frandorturtles/flora/portfolio/FLORA_Smart_Plant_Companion.html

# Flora

frandorturtles

frandorturtles

SHT40

TSL25911

5 V

frandorturtles

frandorturtles

2

ESP32-C3

USB-C, 5 V

KiCad 7

Flora
FRANDORTURTLES
