frandorturtles/flora/portfolio/assets/bottom_view.png

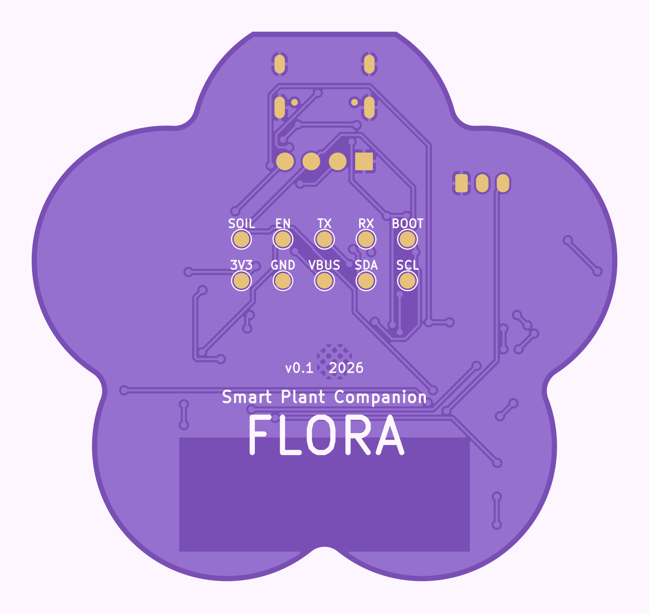
portfolio/assets/bottom_view.png
