frandorturtles/flora/renders/FLORA_board.step

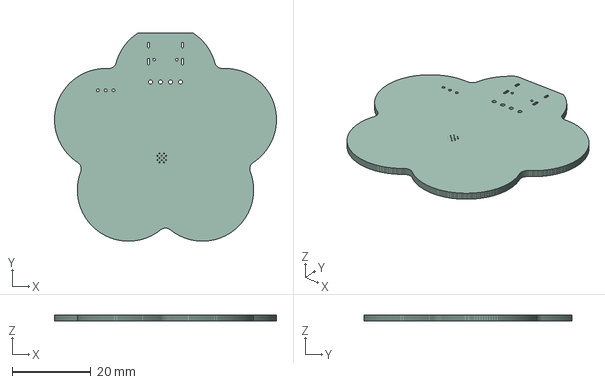
[picture p3: CAD file, 2026-10-29]
renders/FLORA_board.step
56.4 x 52.9 x 1.60 mm
