frandorturtles/flora/renders/assembly_top_fab.png

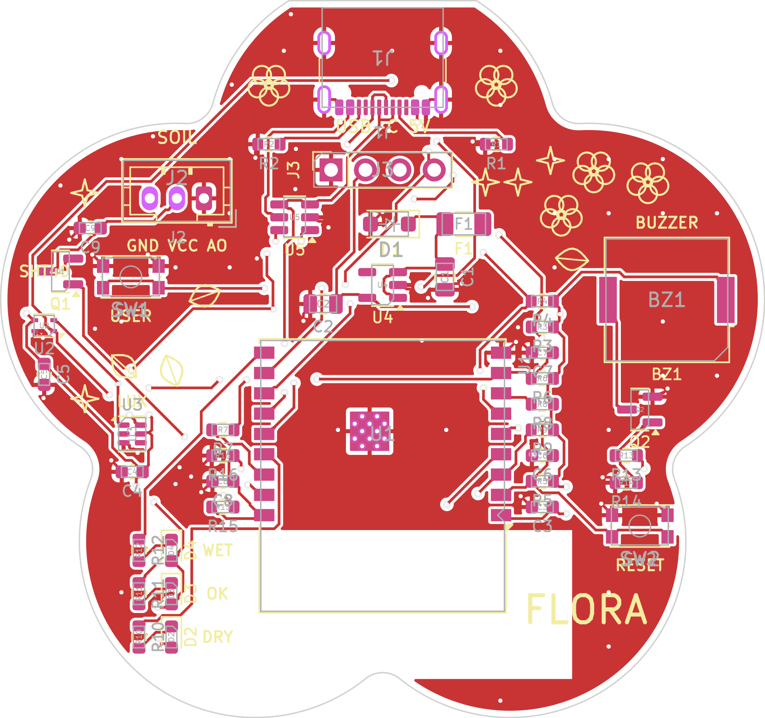
renders/assembly_top_fab.png
