frandorturtles/flora/CHANGELOG.md

# Changelog

## v0.1 — 2026-10-26
- Primer diseño completo: esquemático, PCB en forma de flor, firmware, Gerbers, documentación.
- Sin fabricar ni probar. Ver `documentation/design_review.md` para pendientes.
