frandorturtles/flora/hardware/FLORA.kicad_pcb

## KiCad design hardware/FLORA.kicad_pcb (2026-10-29)

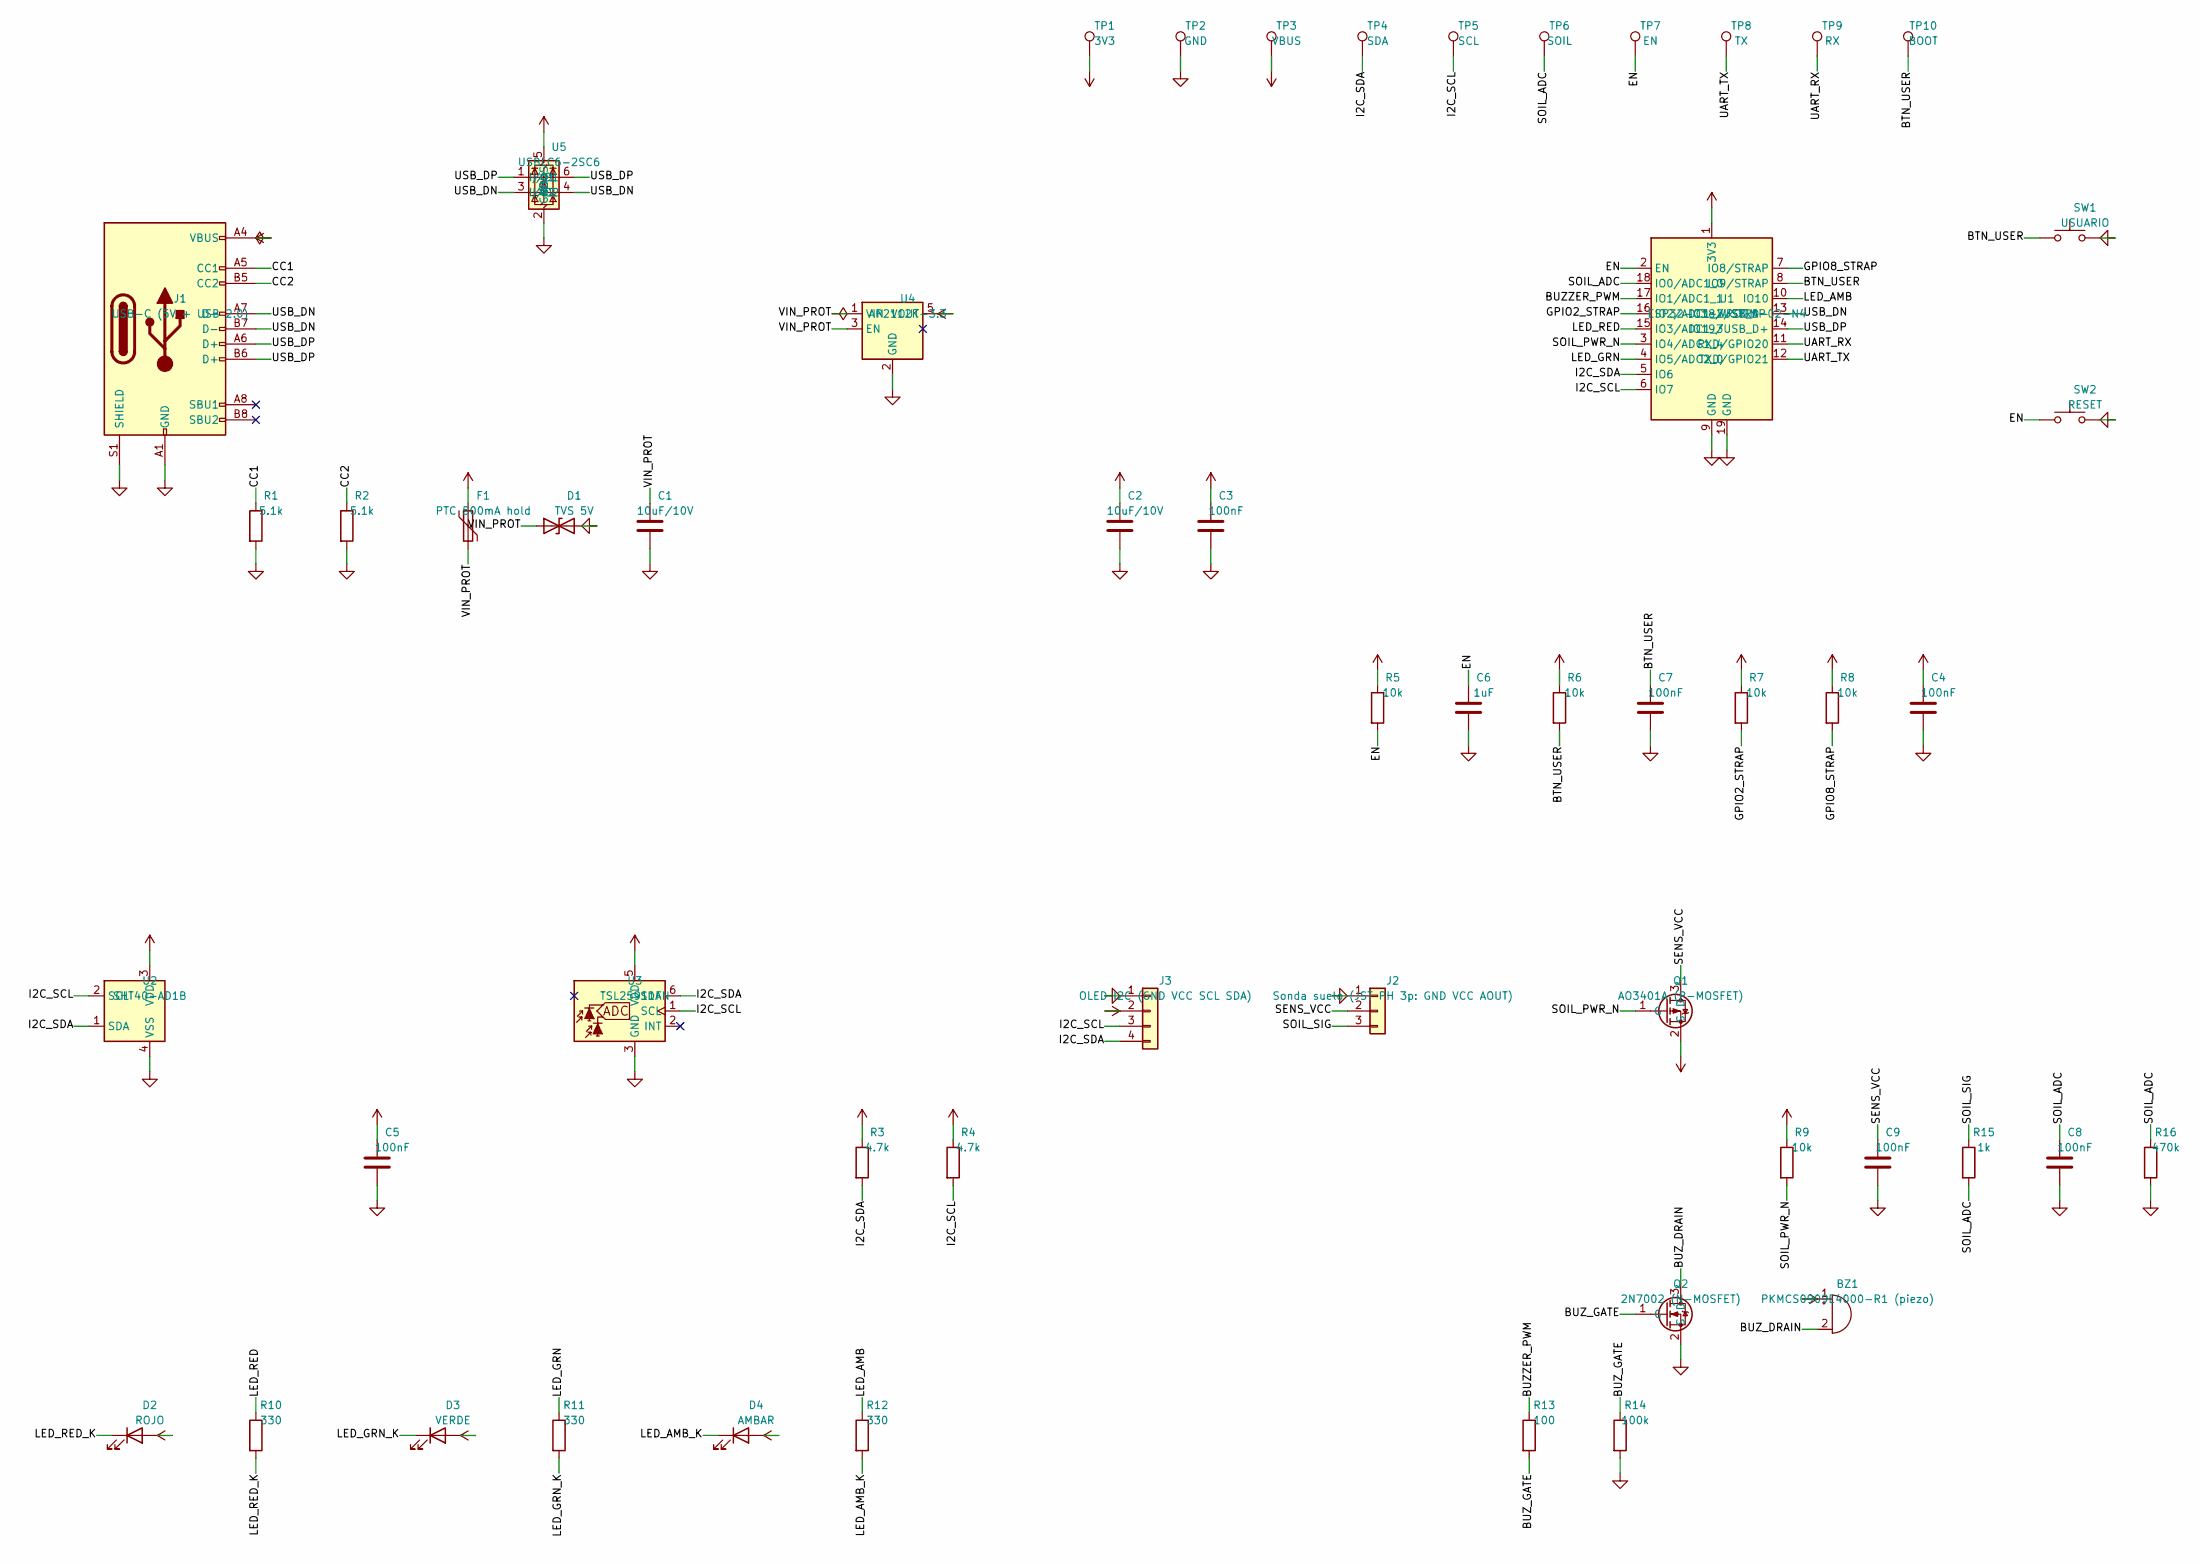
[picture p5: schematic FLORA.kicad_sch, FLORA - Smart Plant Companion]

Parts:
BZ1: PKMCS0909E4000-R1 (piezo); Buzzer_Murata_PKMCS0909E; MPN Murata PKMCS0909E4000-R1
C1, C2: 10uF/10V; C_0805_2012Metric; MPN Samsung CL21A106KPFNNNE
C3, C4, C5, C7, C8, C9: 100nF; C_0603_1608Metric; MPN Samsung CL10B104KB8NNNC
C6: 1uF; C_0603_1608Metric; MPN Samsung CL10A105KB8NNNC
D1: TVS 5V; D_SOD-123F; MPN Littelfuse SMF5.0A (verificar polaridad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
D2: ROJO; LED_0603_1608Metric; MPN LED 0603 rojo
D3: VERDE; LED_0603_1608Metric; MPN LED 0603 verde
D4: AMBAR; LED_0603_1608Metric; MPN LED 0603 ambar
F1: PTC 500mA hold; Fuse_1206_3216Metric; MPN Bourns MF-MSMF050-2 (o equivalente)
J1: USB-C (5V + USB 2.0); USB_C_Receptacle_GCT_USB4105-xx-A_16P_TopMnt_Horizontal; MPN GCT USB4105-GF-A
J2: Sonda suelo (JST PH 3p: GND VCC AOUT); JST_PH_B3B-PH-K_1x03_P2.00mm_Vertical; MPN JST B3B-PH-K-S
J3: OLED I2C (GND VCC SCL SDA); PinSocket_1x04_P2.54mm_Vertical; MPN Socket hembra 1x4 2.54mm
Q1: AO3401A (P-MOSFET); SOT-23; MPN Alpha&Omega AO3401A
Q2: 2N7002 (N-MOSFET); SOT-23; MPN 2N7002 (onsemi/Nexperia)
R1, R2: 5.1k; R_0603_1608Metric; MPN Yageo RC0603FR-075K1L
R3, R4: 4.7k; R_0603_1608Metric; MPN Yageo RC0603FR-074K7L
R5, R6, R7, R8, R9: 10k; R_0603_1608Metric; MPN Yageo RC0603FR-0710KL
R10, R11, R12: 330; R_0603_1608Metric; MPN Yageo RC0603FR-07330RL
R13: 100; R_0603_1608Metric; MPN Yageo RC0603FR-07100RL
R14: 100k; R_0603_1608Metric; MPN Yageo RC0603FR-07100KL
R15: 1k; R_0603_1608Metric; MPN Yageo RC0603FR-071KL
R16: 470k; R_0603_1608Metric; MPN Yageo RC0603FR-07470KL
SW1: USUARIO; SW_Push_1P1T_NO_CK_KMR2; MPN C&K KMR2 (o equivalente)
SW2: RESET; SW_Push_1P1T_NO_CK_KMR2; MPN C&K KMR2 (o equivalente)
TP1: 3V3; TestPoint_Pad_D1.5mm; MPN Pad de prueba
TP2: GND; TestPoint_Pad_D1.5mm; MPN Pad de prueba
TP3: VBUS; TestPoint_Pad_D1.5mm; MPN Pad de prueba
TP4: SDA; TestPoint_Pad_D1.5mm; MPN Pad de prueba
TP5: SCL; TestPoint_Pad_D1.5mm; MPN Pad de prueba
TP6: SOIL; TestPoint_Pad_D1.5mm; MPN Pad de prueba
TP7: EN; TestPoint_Pad_D1.5mm; MPN Pad de prueba
TP8: TX; TestPoint_Pad_D1.5mm; MPN Pad de prueba
TP9: RX; TestPoint_Pad_D1.5mm; MPN Pad de prueba
TP10: BOOT; TestPoint_Pad_D1.5mm; MPN Pad de prueba
U1: ESP32-C3-WROOM-02-N4; ESP32-C3-WROOM-02; MPN Espressif ESP32-C3-WROOM-02-N4
U2: SHT40-AD1B; Sensirion_DFN-4_1.5x1.5mm_P0.8mm_SHT4x_NoCentralPad; MPN Sensirion SHT40-AD1B-R2
U3: TSL25911FN; AMS_TSL25911FN; MPN ams-OSRAM TSL25911FN
U4: AP2112K-3.3; SOT-23-5; MPN Diodes Inc. AP2112K-3.3TRG1
U5: USBLC6-2SC6; SOT-23-6; MPN STMicroelectronics USBLC6-2SC6

Connections:
+3V3: BZ1.1 (+), C2.1, C3.1, C4.1, C5.1, D2.2 (A), D3.2 (A), D4.2 (A), J3.2, Q1.2 (S), R3.1, R4.1, R5.1, R6.1, R7.1, R8.1, R9.1, TP1.1, U1.1 (3V3), U2.3 (VDD), U3.5 (VDD), U4.5 (VOUT)
/BTN_USER: C7.1, R6.2, SW1.1, TP10.1, U1.8 (IO9/STRAP)
/BUZZER_PWM: R13.1, U1.17 (IO1/ADC1_1)
/BUZ_DRAIN: BZ1.2 (-), Q2.3 (D)
/BUZ_GATE: Q2.1 (G), R13.2, R14.1
/CC1: J1.A5 (CC1), R1.1
/CC2: J1.B5 (CC2), R2.1
/EN: C6.1, R5.2, SW2.1, TP7.1, U1.2 (EN)
/GPIO2_STRAP: R7.2, U1.16 (IO2/ADC1_2/STRAP)
/GPIO8_STRAP: R8.2, U1.7 (IO8/STRAP)
/I2C_SCL: J3.3, R4.2, TP5.1, U1.6 (IO7), U2.2 (SCL), U3.1 (SCL)
/I2C_SDA: J3.4, R3.2, TP4.1, U1.5 (IO6), U2.1 (SDA), U3.6 (SDA)
/LED_AMB: R12.1, U1.10 (IO10)
/LED_AMB_K: D4.1 (K), R12.2
/LED_GRN: R11.1, U1.4 (IO5/ADC2_0)
/LED_GRN_K: D3.1 (K), R11.2
/LED_RED: R10.1, U1.15 (IO3/ADC1_3)
/LED_RED_K: D2.1 (K), R10.2
/SENS_VCC: C9.1, J2.2, Q1.3 (D)
/SOIL_ADC: C8.1, R15.2, R16.1, TP6.1, U1.18 (IO0/ADC1_0)
/SOIL_PWR_N: Q1.1 (G), R9.2, U1.3 (IO4/ADC1_4)
/SOIL_SIG: J2.3, R15.1
/UART_RX: TP9.1, U1.11 (RXD/GPIO20)
/UART_TX: TP8.1, U1.12 (TXD/GPIO21)
/USB_DN: J1.A7 (D-), J1.B7 (D-), U1.13 (IO18/USB_D-), U5.3 (I/O2), U5.4 (I/O2)
/USB_DP: J1.A6 (D+), J1.B6 (D+), U1.14 (IO19/USB_D+), U5.1 (I/O1), U5.6 (I/O1)
/VIN_PROT: C1.1, D1.1 (A1), F1.2, U4.1 (VIN), U4.3 (EN)
GND: C1.2, C2.2, C3.2, C4.2, C5.2, C6.2, C7.2, C8.2, C9.2, D1.2 (A2), J1.A1 (GND), J1.A12 (GND), J1.B1 (GND), J1.B12 (GND), J1.S1 (SHIELD), J2.1, J3.1, Q2.2 (S), R1.2, R2.2, R14.2, R16.2, SW1.2, SW2.2, TP2.1, U1.9 (GND), U1.19 (GND), U2.4 (VSS), U3.3 (GND), U4.2 (GND), U5.2 (GND)
VBUS: F1.1, J1.A4 (VBUS), J1.A9 (VBUS), J1.B4 (VBUS), J1.B9 (VBUS), TP3.1, U5.5 (VBUS)

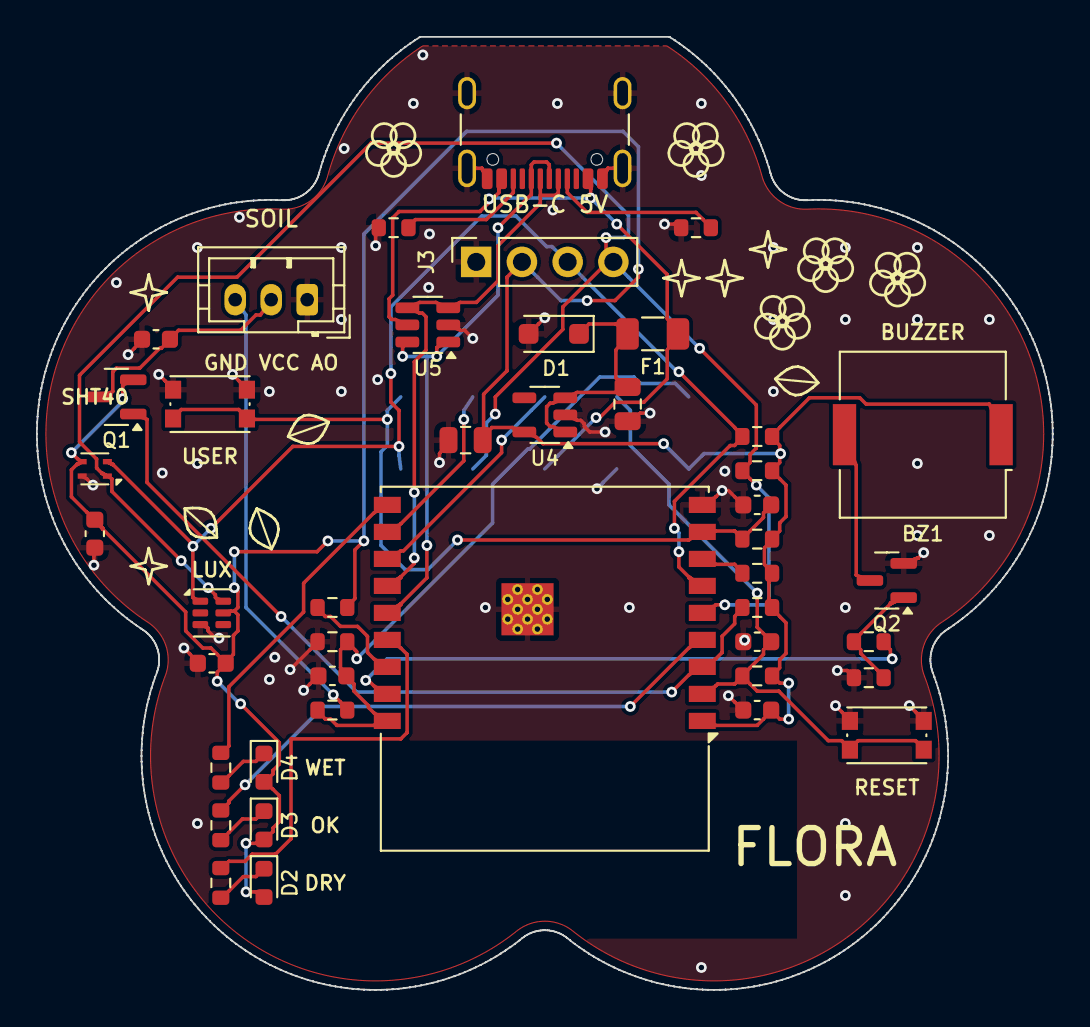
[picture p6: board FLORA.kicad_pcb from above]

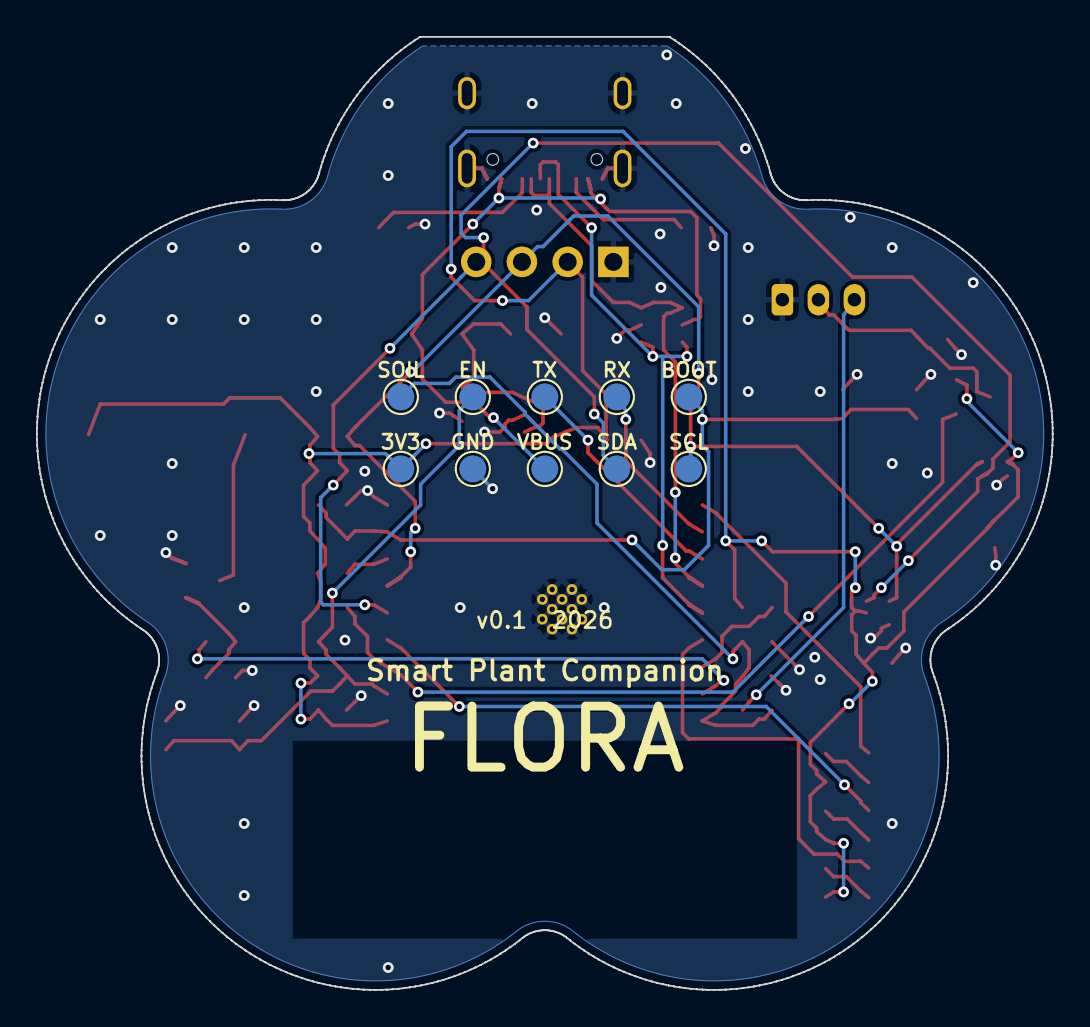
[picture p7: board FLORA.kicad_pcb from below]

Board: 2 copper layers, 56.4 x 52.9 mm, 53 parts (10 on the bottom side), 29 nets.
